jean-michel-gonet/rc-to-dc-motor-controller/documentation/41CB1AE9-CCEF-45F4-A7F7-0A9BE559B6FB.png

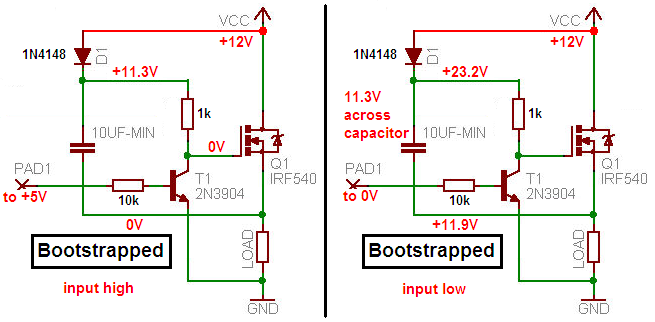
documentation/41CB1AE9-CCEF-45F4-A7F7-0A9BE559B6FB.png
