jean-michel-gonet/rc-to-dc-motor-controller/documentation/3041440-40.jpg

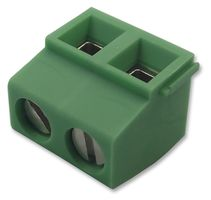
documentation/3041440-40.jpg
