jean-michel-gonet/rc-to-dc-motor-controller/documentation/bootstrap-capacitor-buck-dc-to-dc-converter-mosfet-n-high-side.png

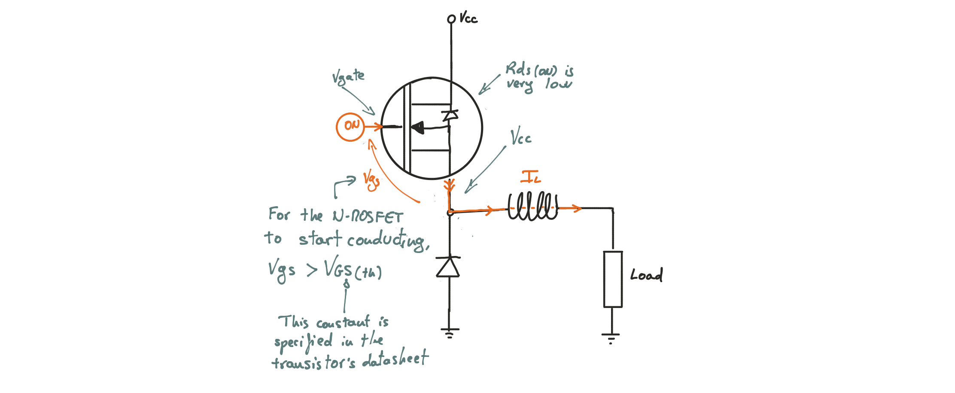
documentation/bootstrap-capacitor-buck-dc-to-dc-converter-mosfet-n-high-side.png
