jean-michel-gonet/rc-to-dc-motor-controller/documentation/bootstrap-capacitor-buck-dc-to-dc-converter-mosfet-n-how-it-works.png

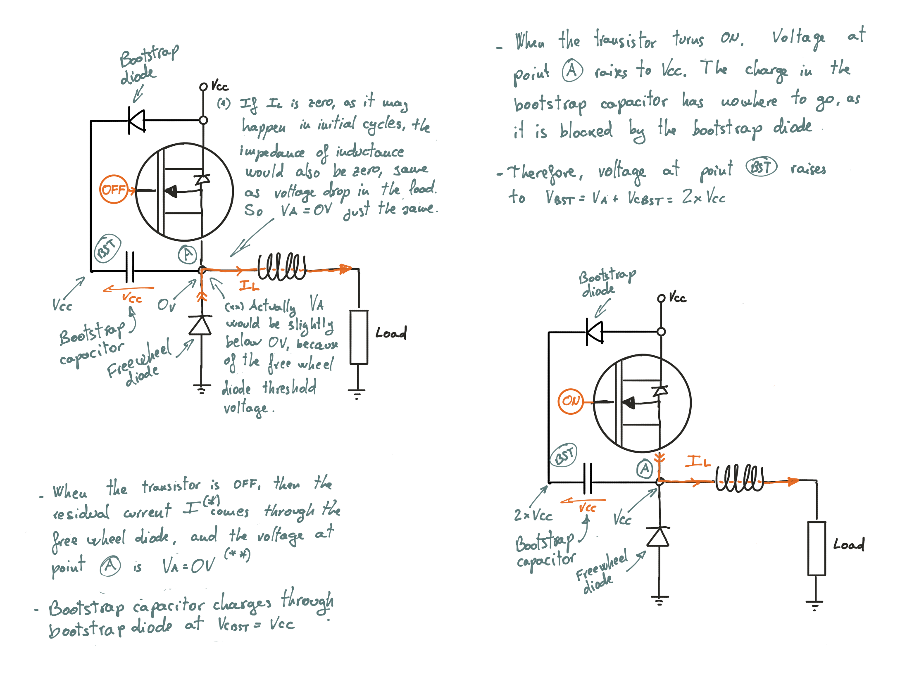
documentation/bootstrap-capacitor-buck-dc-to-dc-converter-mosfet-n-how-it-works.png
