jean-michel-gonet/rc-to-dc-motor-controller/documentation/bootstrap-capacitor-buck-dc-to-dc-converter-mosfet-n-schematic-with-bjt-high-side-driver.png

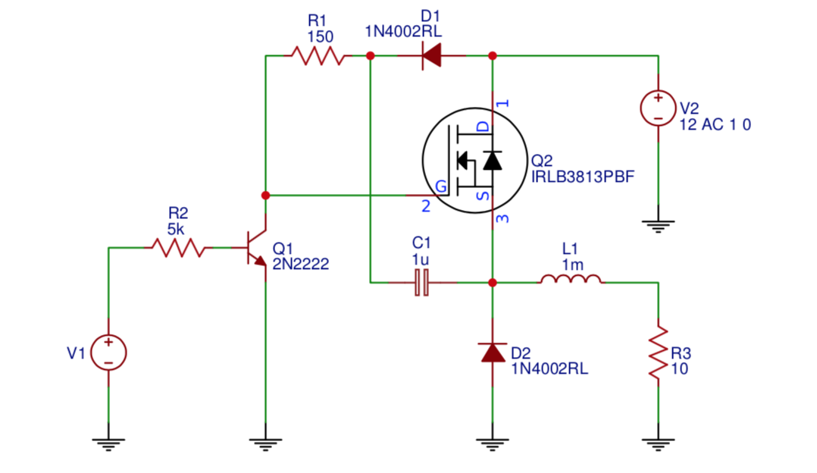
documentation/bootstrap-capacitor-buck-dc-to-dc-converter-mosfet-n-schematic-with-bjt-high-side-driver.png
