jean-michel-gonet/rc-to-dc-motor-controller/documentation/max16955-dc-to-dc-converter-buck-schematic.png

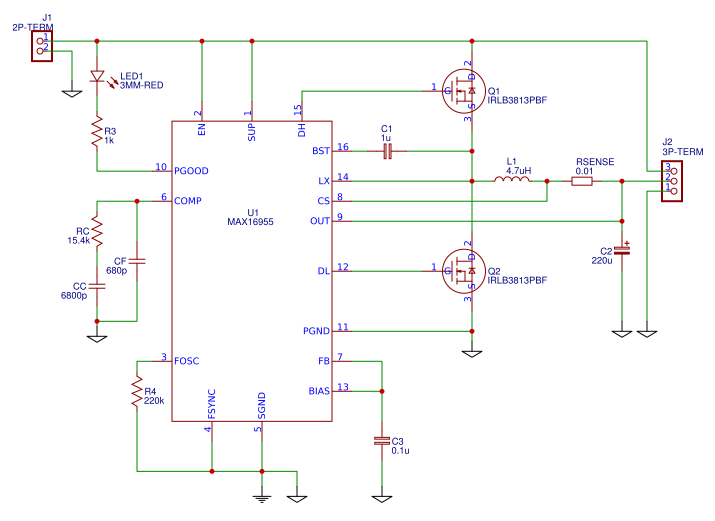
documentation/max16955-dc-to-dc-converter-buck-schematic.png
