jean-michel-gonet/rc-to-dc-motor-controller/c-module.X/c-module-prototype-schematic.pdf

VCC | 10
VCC | 10

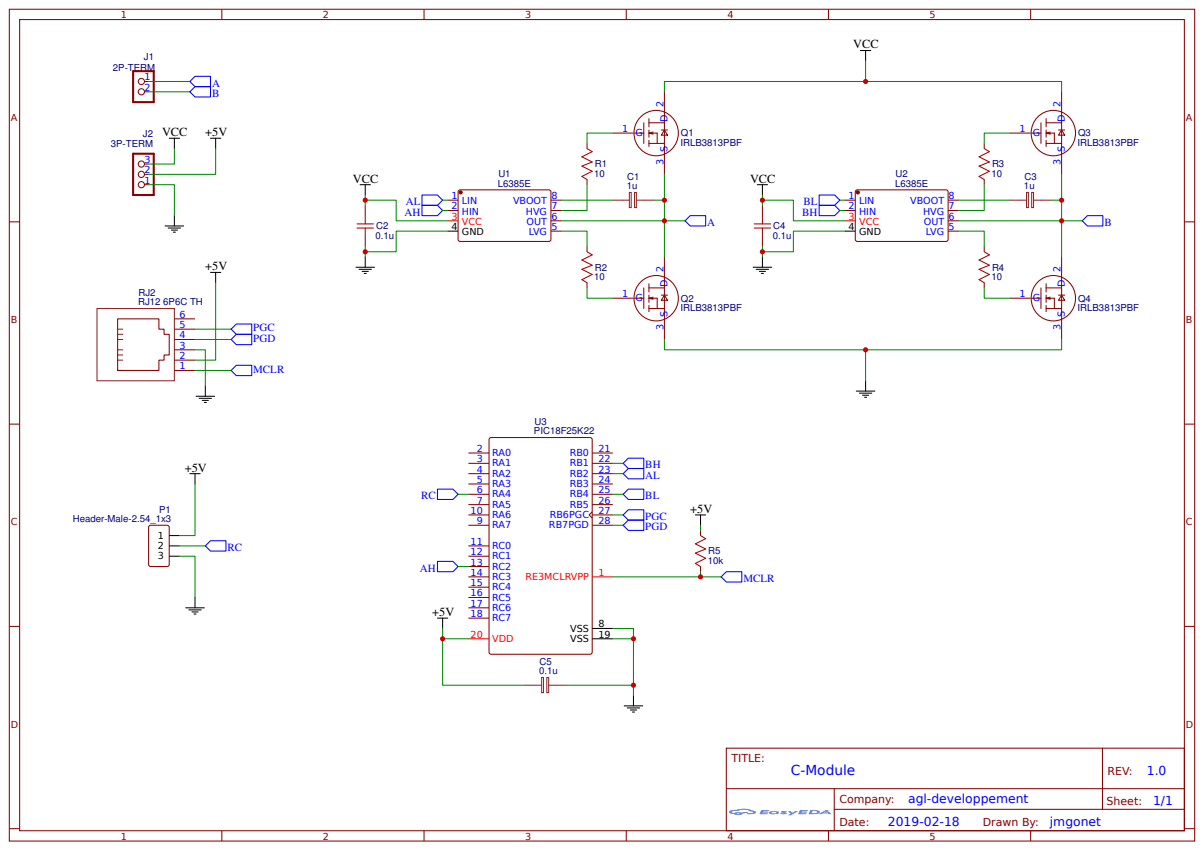
[picture p9: page 1]
