jean-michel-gonet/rc-to-dc-motor-controller/(list of files, drawings)

Other design files:
p-module.X/p-module-ncp3020a.pdsprj
p-module.X/p-module.pdsprj
