jean-michel-gonet/rc-to-dc-motor-controller/(threads)

Thread 1 (2019-03-09):

Add LED indicators for 12V power, 5V power and RC signal

jean-michel-gonet, 2019-03-09:
# Why?

- Because it is nice.
- Because when setting up a (P) Module and one or more (C) Modules, the user needs to be reassured about connections.

# Condition of satisfaction
LED code:
- LED 1 lights up when RC input is POSITIVE.
- LED 2 lights up when RC input is NEGATIVE.
- Both LED are off when RC input is NEUTRAL.
- Both LED are on when there is no RC signal

Initialization procedure:
- When control program starts up, it turns off the motor.
- It waits until RC signal is NEUTRAL before any attempt at feeding the motor.
- When the RC signal disappears, it turns off the motor (and lights up the two LED).

jean-michel-gonet, 2019-06-23:
Changed the condition of satisfaction, based on initial feedback from using the prototype

Closed 2019-06-26.

Thread 2 (2019-03-09):

Motor stops when moving from full forward to full backwards

jean-michel-gonet, 2019-03-09:
# To reproduce
- Wire up everything.
- Push the RC emitter rod to full forward.
- Move it as fast as possible to full backwards.

The motor stops.

You can recover to move the RC emitter rod to neutral and then backwards again.

It doesn't happen always.

jean-michel-gonet, 2019-06-26:
After testing:
- The µP resets when switching from positive to negative or vice-versa.
- https://electronics.stackexchange.com/questions/81252/what-could-cause-a-microcontroller-to-unexpectedly-reset

jean-michel-gonet, 2019-06-26:
_ESD coupling into the reset pin. I've seen this happen when completely unrelated equipment gets turned on on the same desk. Make sure there's enough capacitance on the reset pin, possibly as much as 1 uF._

- As described in http://ww1.microchip.com/downloads/en/DeviceDoc/51474a.pdf, add a 1µF and 470Ω resistor in the MCLRE pin.

jean-michel-gonet, 2019-06-26:
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
