jean-michel-gonet/rc-to-dc-motor-controller/(commit log)

2019-01-31 Schematic for p-module - WIP
    [p-module.pdsprj]
2019-02-18 Prototypes are ready
    [c-module-prototype-bom.ods, p-module-prototype-bom.ods, p-module.pdsprj]
2019-03-03 Use a MPLABX friendly folder name
    [c-module-prototype-bom.ods]
2019-03-04 Capture PWM signal from RC receiver
2019-04-28 Generate PWM signal for DC motor
2019-04-28 Initial brain-storm about p.module
    [p-module-ncp3020a.pdsprj, p-module-prototype-bom.ods]
2019-04-28 Let's have all files in one folder
    [p-module-ncp3020a.pdsprj, p-module-prototype-bom.ods, p-module.pdsprj]
2019-04-29 Using PWM1, and calibrated the duty cycle
2019-06-24 Concerns #1 - Have a power state machine that waits for neutral position before issuing power to the motor
2019-06-24 Concerns #1 - Output the signaling to the leds
